lbrushmanl/ENEL-372-Solar-Car-Sync-Buck/README.md

# ENEL-372-Solar-Car-Sync-Buck
This project involved making a buck converter that would be used to power a small solar-powered RC car. 

Image of my Synchronous converter
