lbrushmanl/ENEL-372-Solar-Car-Sync-Buck/Solar Car Project/Async.pdf

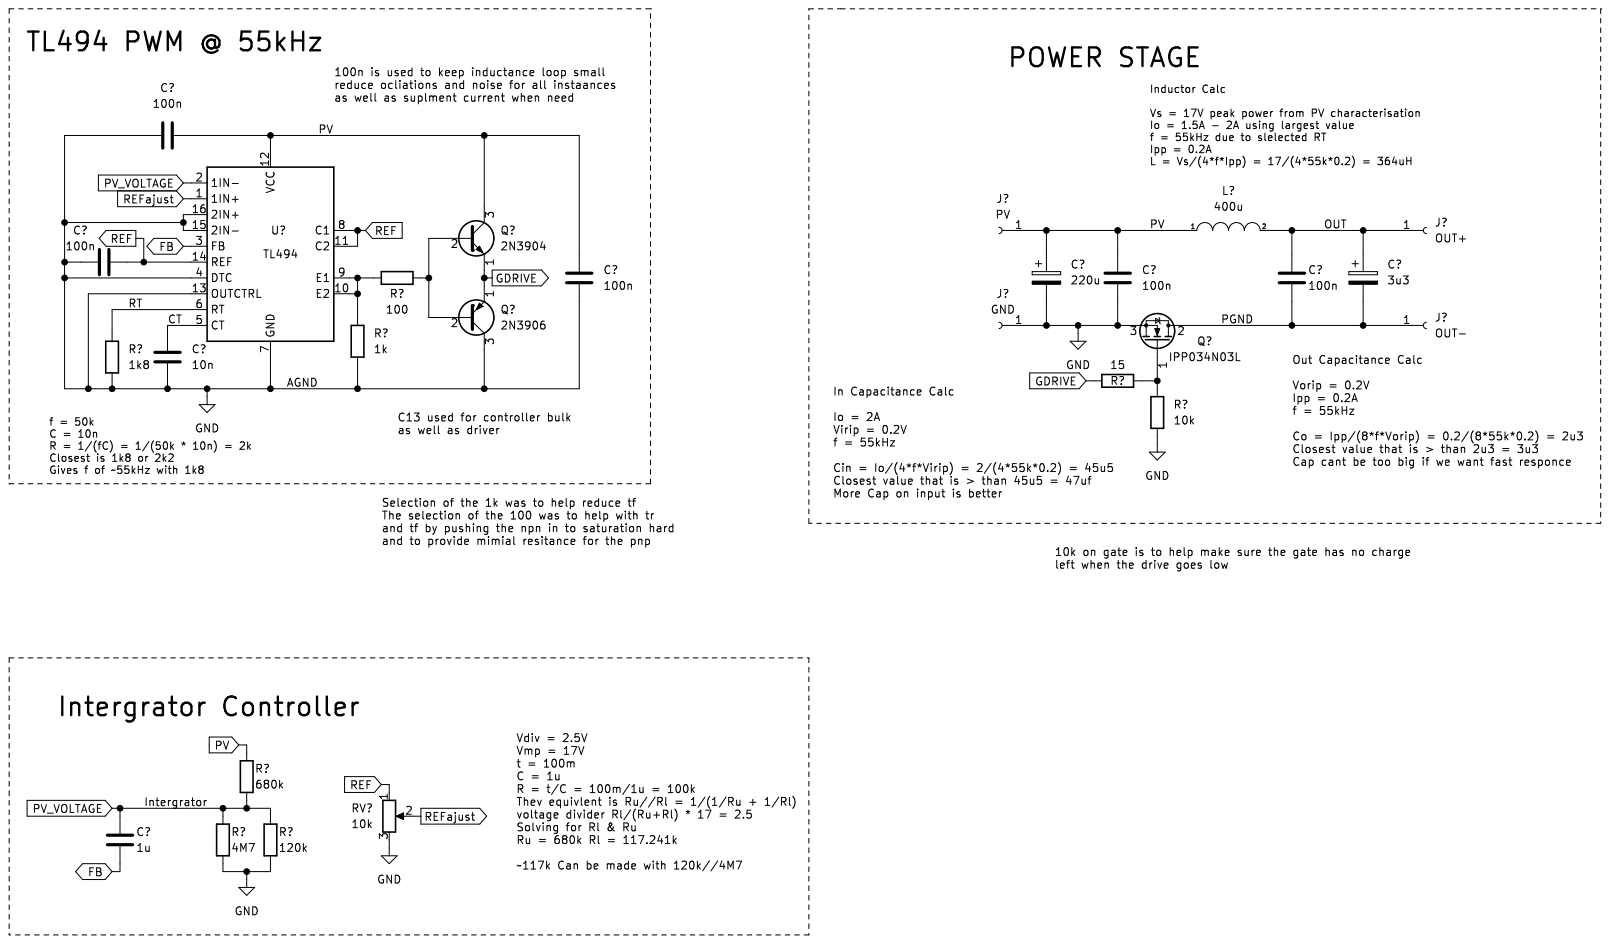
[picture p1: page 1]
