lbrushmanl/ENEL-372-Solar-Car-Sync-Buck/Solar Car Project/Sync.pdf

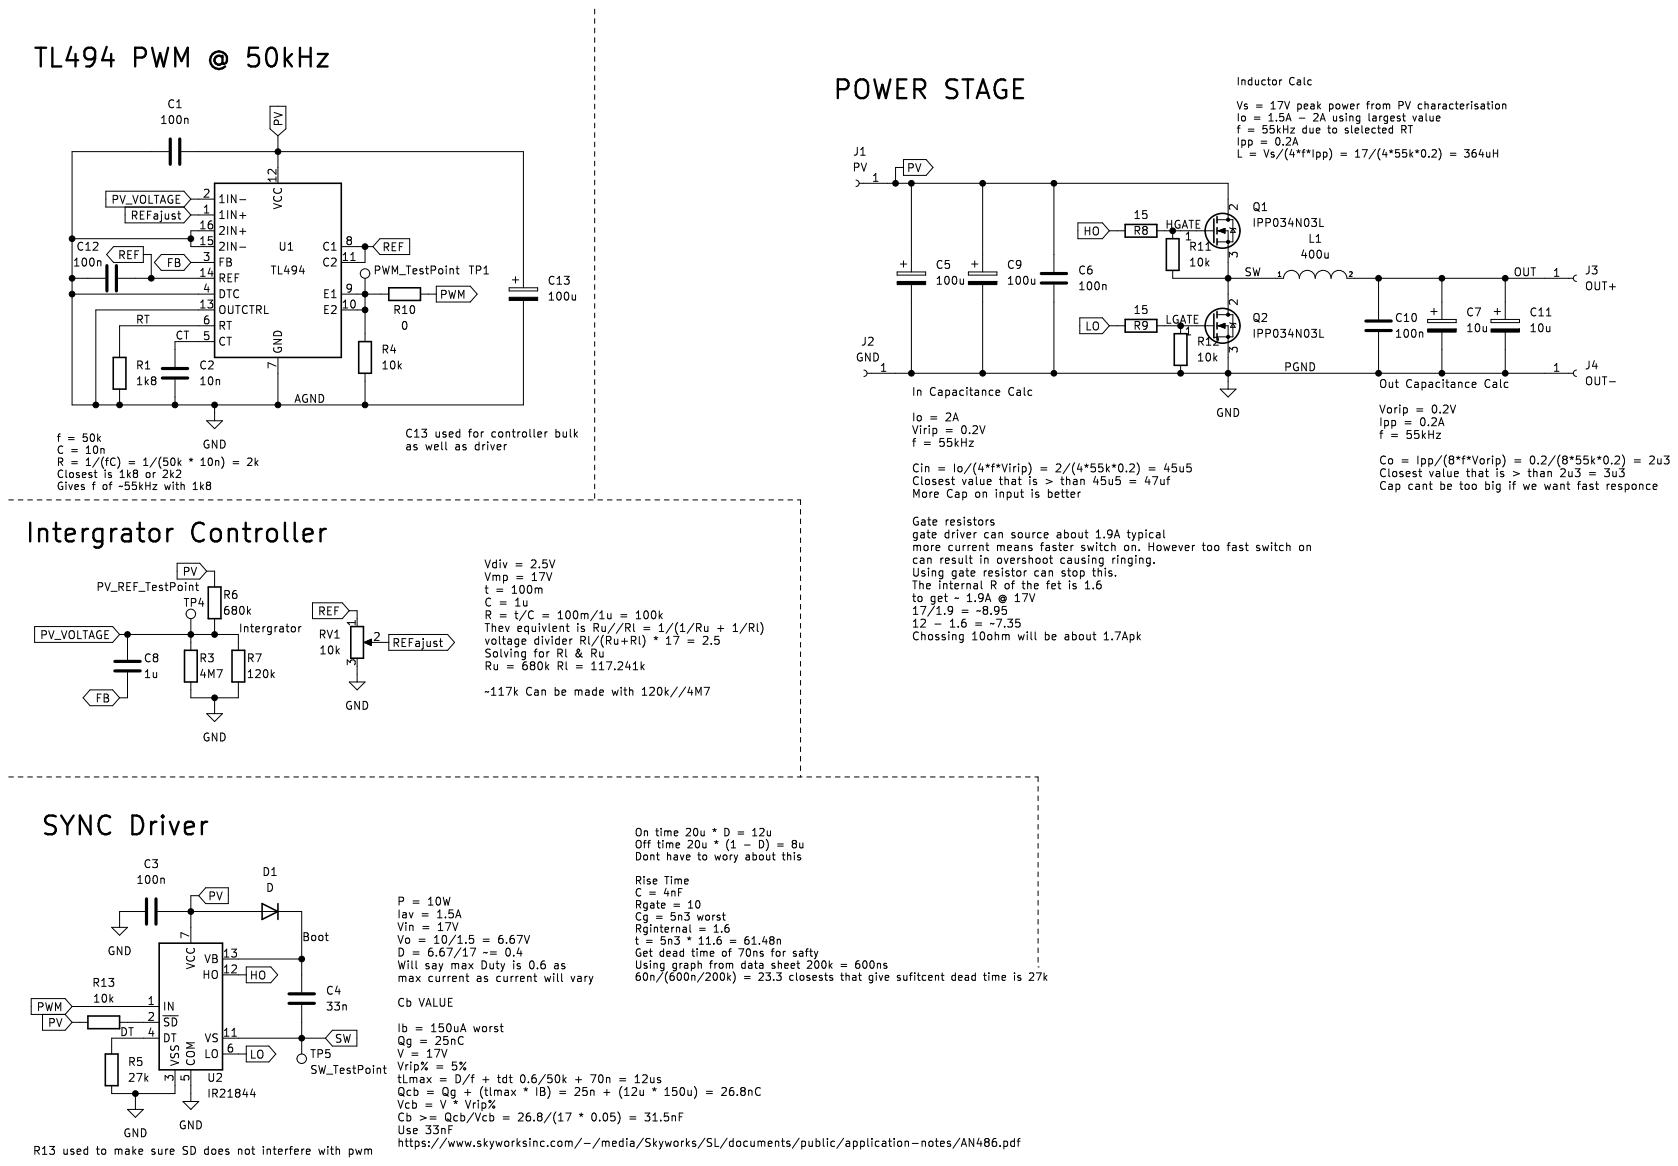
[picture p2: page 1]
