lbrushmanl/ENEL-372-Solar-Car-Sync-Buck/Solar Car Project/LTspice/Solar-Car-Buck.asc

C1: EuropeanCap; 10n
C2: EuropeanPolcap; 10µ
C3: EuropeanPolcap; 68µ
C4: EuropeanCap; 100n
C5: EuropeanCap; 100n
C7: EuropeanCap; 100n
D1: schottky; RBS2LAM40B
L1: ind; 400µ
LOAD: EuropeanResistor; 3
M1: nmos; IPP034N03L
Q2: npn; BC337-40
Q3: pnp; BC327-40
R1: EuropeanResistor; 1k8
R2: EuropeanResistor; 10k
R3: EuropeanResistor; 10k
R9: EuropeanResistor; 10k
R18: EuropeanResistor; 610
R22: EuropeanResistor; 15
U1: TL494_CEH
V1: voltage; 15
Named nets: 0, REF, MPP-VOLT, PV, GATE, PWM, OUT, Drain
.tran 0 5ms 0 startup
Using 10n and 1k8 results in a freqency of 55kHz 
Which is about our chosen freqency of 50kHz.
This diode has aprox same spec as the one 
we are using
FET Driver
PWM Generation 50% duty
Setting PWM to 50%
Filter
