lbrushmanl/ENEL-372-Solar-Car-Sync-Buck/Solar Car Project/Kicad/Kei Carden Solar Buck/Solar Buck.kicad_pcb

## KiCad design Solar Car Project/Kicad/Kei Carden Solar Buck/Solar Buck.kicad_pcb (2022-11-30)

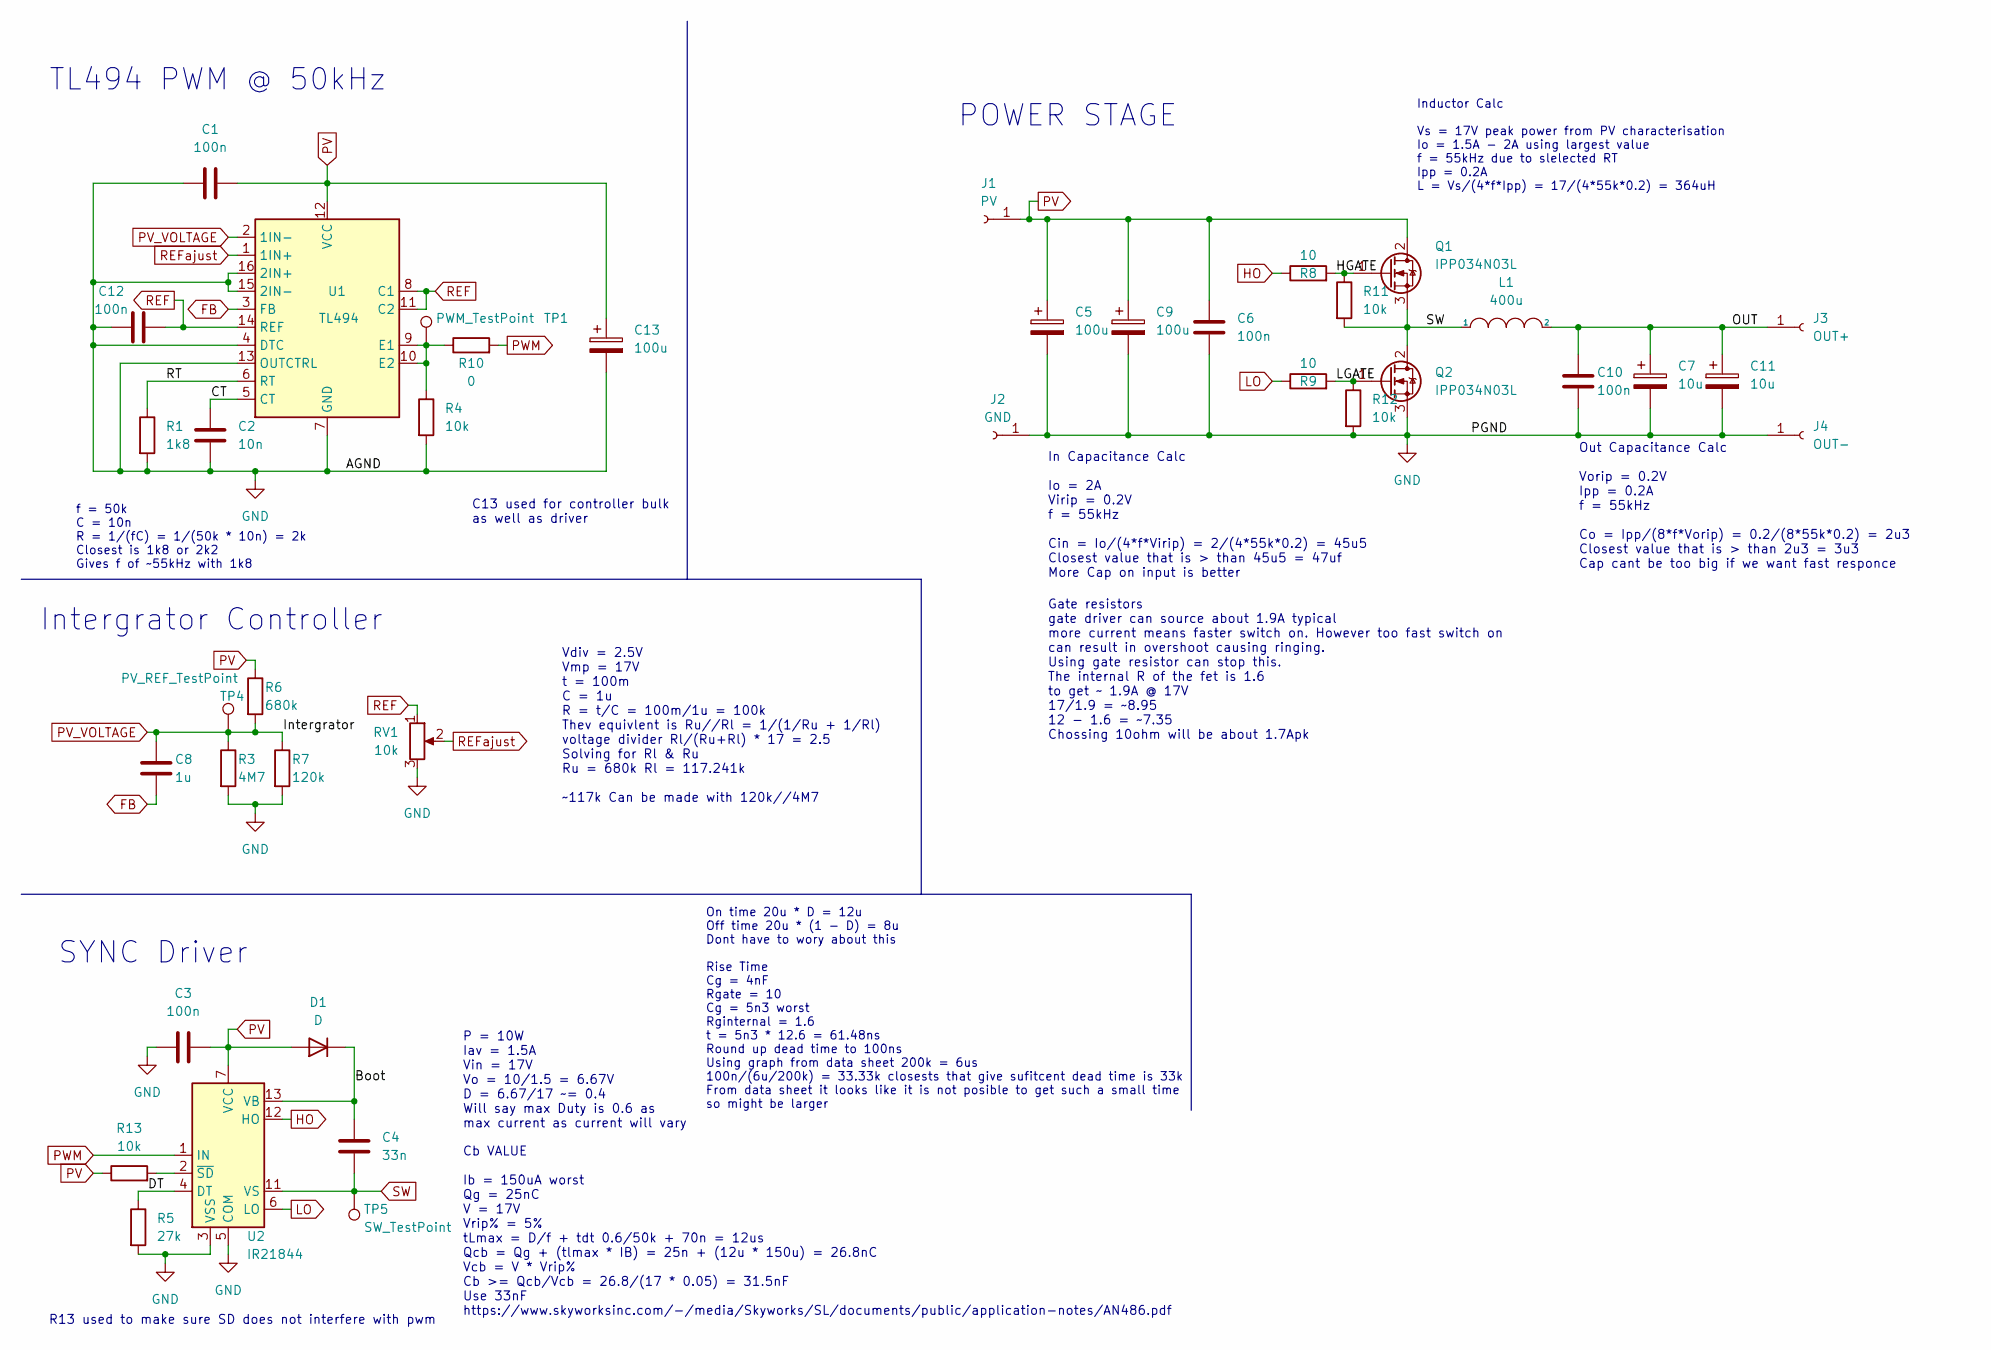
[picture p3: schematic Solar Buck.kicad_sch, Sync Solar Car Kei Carden]

Parts:
C1, C3, C6, C10, C12: 100n; C_Disc_D3.4mm_W2.1mm_P2.50mm
C2: 10n; C_Rect_L7.0mm_W2.5mm_P5.00mm
C4: 33n; C_Rect_L7.0mm_W2.5mm_P5.00mm
C5: 100u; CP_Radial_D8.0mm_P5.00mm
C7, C11: 10u; CP_Radial_D5.0mm_P2.50mm
C8: 1u; C_Rect_L7.0mm_W4.5mm_P5.00mm
C9, C13: 100u; CP_Radial_D5.0mm_P2.50mm
D1: D; D_A-405_P12.70mm_Horizontal
J1: PV; Spade-Terminal
J2: GND; Spade-Terminal
J3: OUT+; Spade-Terminal
J4: OUT-; Spade-Terminal
L1: 400u; RM8 Former
Q1, Q2: IPP034N03L; TO-220-3_Vertical
R1: 1k8; R_Axial_DIN0207_L6.3mm_D2.5mm_P7.62mm_Horizontal
R3: 4M7; R_Axial_DIN0207_L6.3mm_D2.5mm_P7.62mm_Horizontal
R4, R13: 10k; R_Axial_DIN0207_L6.3mm_D2.5mm_P7.62mm_Horizontal
R5: 27k; R_Axial_DIN0207_L6.3mm_D2.5mm_P7.62mm_Horizontal
R6: 680k; R_Axial_DIN0207_L6.3mm_D2.5mm_P7.62mm_Horizontal
R7: 120k; R_Axial_DIN0207_L6.3mm_D2.5mm_P7.62mm_Horizontal
R8: 10; R_Axial_DIN0207_L6.3mm_D2.5mm_P2.54mm_Vertical
R9: 10; R_Axial_DIN0207_L6.3mm_D2.5mm_P7.62mm_Horizontal
R10: 0; R_Axial_DIN0207_L6.3mm_D2.5mm_P7.62mm_Horizontal
R11, R12: 10k; R_Axial_DIN0207_L6.3mm_D2.5mm_P2.54mm_Vertical
RV1: 10k; Potentiometer_Bourns_3296W_Vertical
TP1: PWM_TestPoint; TestPoint_Pad_D1.0mm
TP4: PV_REF_TestPoint; TestPoint_Pad_D1.0mm
TP5: SW_TestPoint; TestPoint_Pad_D1.0mm
U1: TL494; DIP-16_W7.62mm_Socket_LongPads
U2: IR21844; DIP-14_W7.62mm_Socket_LongPads

Connections:
/Boot: C4.1, D1.1 (K), U2.13 (VB)
/CT: C2.1, U1.5 (CT)
/DT: R5.1, U2.4 (DT)
/HGATE: Q1.1 (G), R8.2, R11.1
/LGATE: Q2.1 (G), R9.2, R12.1
/OUT: C7.1, C10.1, C11.1, J3.1, L1.2
/RT: R1.1, U1.6 (RT)
FB: C8.2, U1.3 (FB)
GND: C1.1, C2.2, C3.1, C5.2, C6.2, C7.2, C9.2, C10.2, C11.2, C12.1, C13.2, J2.1, J4.1, Q2.3 (S), R1.2, R3.2, R4.2, R5.2, R7.2, R12.2, RV1.3, U1.4 (DTC), U1.7 (GND), U1.13 (OUTCTRL), U1.15 (2IN-), U1.16 (2IN+), U2.3 (VSS), U2.5 (COM)
HO: R8.1, U2.12 (HO)
LO: R9.1, U2.6 (LO)
unnamed: R4.1, R10.1, TP1.1, U1.9 (E1), U1.10 (E2)
unnamed: R13.2, U2.2 (~SD)
PV: C1.2, C3.2, C5.1, C6.1, C9.1, C13.1, D1.2 (A), J1.1, Q1.2 (D), R6.1, R13.1, U1.12 (VCC), U2.7 (VCC)
PV_VOLTAGE: C8.1, R3.1, R6.2, R7.1, TP4.1, U1.2 (1IN-); also elsewhere on the board
PWM: R10.2, U2.1 (IN)
REF: C12.2, RV1.1, U1.8 (C1), U1.11 (C2), U1.14 (REF)
REFajust: RV1.2, U1.1 (1IN+)
SW: C4.2, L1.1, Q1.3 (S), Q2.2 (D), R11.2, TP5.1, U2.11 (VS)

Notes on the sheet:
C13 used for controller bulk as well as driver
POWER STAGE
Intergrator Controller
P = 10W Iav = 1.5A Vin = 17V Vo = 10/1.5 = 6.67V D = 6.67/17 ~= 0.4 Will say max Duty is 0.6 as max current as current will vary
Out Capacitance Calc Vorip = 0.2V Ipp = 0.2A f = 55kHz Co = Ipp/(8*f*Vorip) = 0.2/(8*55k*0.2) = 2u3 Closest value that is > than 2u3 = 3u3 Cap cant be too big if we want fast responce
In Capacitance Calc Io = 2A Virip = 0.2V f = 55kHz Cin = Io/(4*f*Virip) = 2/(4*55k*0.2) = 45u5 Closest value that is > than 45u5 = 47uf More Cap on input is better
f = 50k C = 10n R = 1/(fC) = 1/(50k * 10n) = 2k Closest is 1k8 or 2k2 Gives f of ~55kHz with 1k8
R13 used to make sure SD does not interfere with pwm
Gate resistors gate driver can source about 1.9A typical more current means faster switch on. However too fast switch on can result in overshoot causing ringing. Using gate resistor can stop this. The internal R of the fet is 1.6 to get ~ 1.9A @ 17V 17/1.9 = ~8.95 12 - 1.6 = ~7.35 Chossing 10ohm wi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
Vdiv = 2.5V Vmp = 17V t = 100m C = 1u R = t/C = 100m/1u = 100k Thev equivlent is Ru//Rl = 1/(1/Ru + 1/Rl) voltage divider Rl/(Ru+Rl) * 17 = 2.5 Solving for Rl & Ru Ru = 680k Rl = 117.241k ~117k Can be made with 120k//4M7
TL494 PWM @ 50kHz
SYNC Driver
On time 20u * D = 12u Off time 20u * (1 - D) = 8u Dont have to wory about this Rise Time Cg = 4nF Rgate = 10 Cg = 5n3 worst Rginternal = 1.6 t = 5n3 * 12.6 = 61.48ns Round up dead time to 100ns Using graph from data sheet 200k = 6us 100n/(6u/200k) = 33.33k closests that give sufitcent dead time is 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
Inductor Calc Vs = 17V peak power from PV characterisation Io = 1.5A - 2A using largest value f = 55kHz due to slelected RT Ipp = 0.2A L = Vs/(4*f*Ipp) = 17/(4*55k*0.2) = 364uH
Cb VALUE Ib = 150uA worst Qg = 25nC V = 17V Vrip% = 5% tLmax = D/f + tdt 0.6/50k + 70n = 12us Qcb = Qg + (tlmax * IB) = 25n + (12u * 150u) = 26.8nC Vcb = V * Vrip% Cb >= Qcb/Vcb = 26.8/(17 * 0.05) = 31.5nF Use 33nF https://www.skyworksinc.com/-/media/Skyworks/SL/documents/public/application-notes/A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

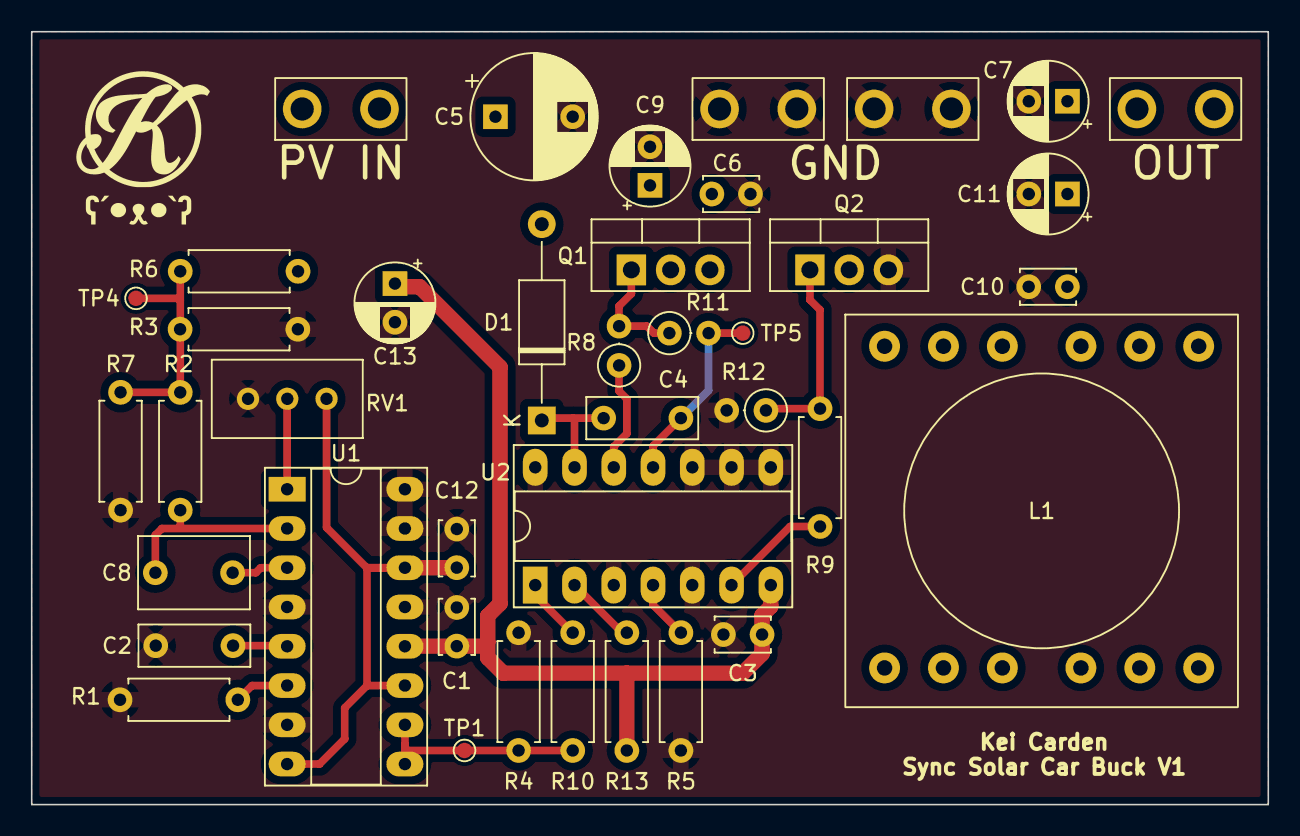
[picture p4: board Solar Buck.kicad_pcb from above]

Board: 2 copper layers, 80.0 x 50.0 mm, 40 parts (0 on the bottom side), 19 nets.

Other parts of the board:
R2: 100k; R_Axial_DIN0207_L6.3mm_D2.5mm_P7.62mm_Horizontal

Their connections:
PV_VOLTAGE: R2.1; also elsewhere on the board
